parimate/Railway-signalling-system/Arduino MEGA 2560/วงจร/Relay to mega.png

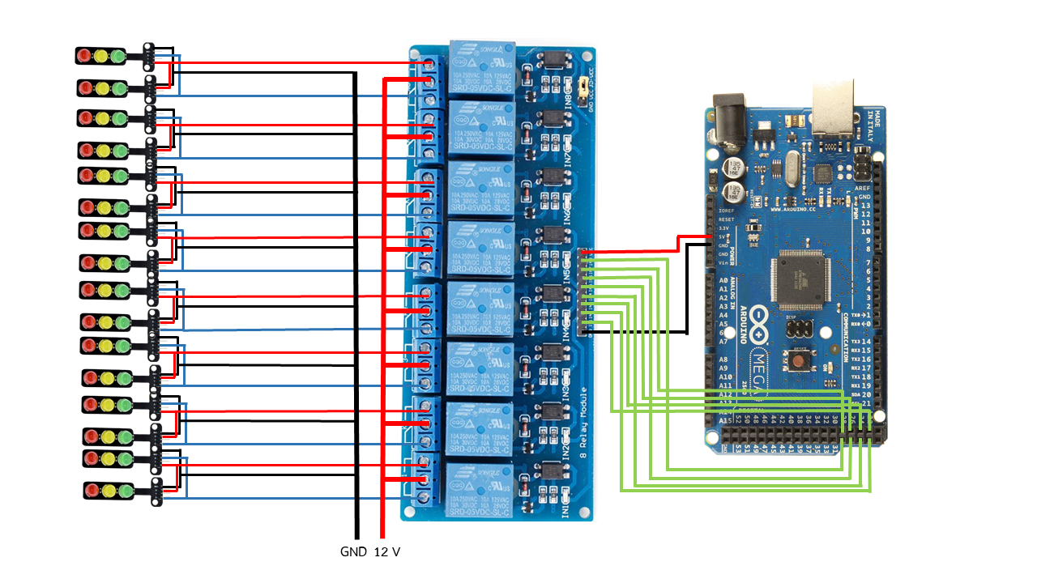
Arduino MEGA 2560/วงจร/Relay to mega.png
