parimate/Railway-signalling-system/NodeMCU ESP8266/RFID to esp8266.jpg

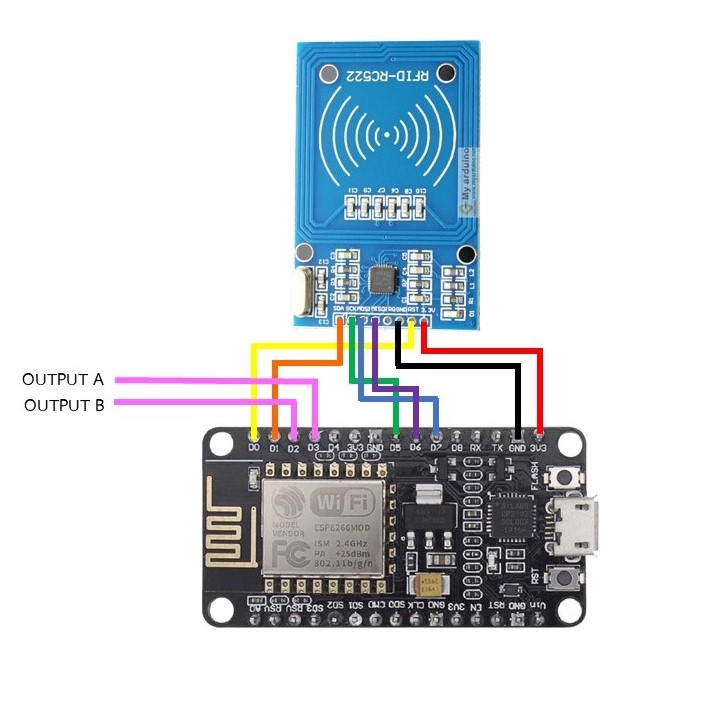
NodeMCU ESP8266/RFID to esp8266.jpg
