parimate/Railway-signalling-system/คู่มือการใช้งาน.pdf

คู่มือการใช้งาน
เมื่อเริ่มระบบการทำงานตัวจอจะแสดงหน้าเมนูหลักขึ้นมา โดยจะแบ่งการใช้งานอยู่ 2 รูปแบบ คือ แบบควบคุมด้วยมือ (Manual) และแบบควบคุมอัตโนมัติ (Auto) หากยังไม่กดปุ่มเลือก รูปแบบการใช้งาน จะไม่สามารถควบคุมการใช้งานของเมนูอื่น ๆ ได้

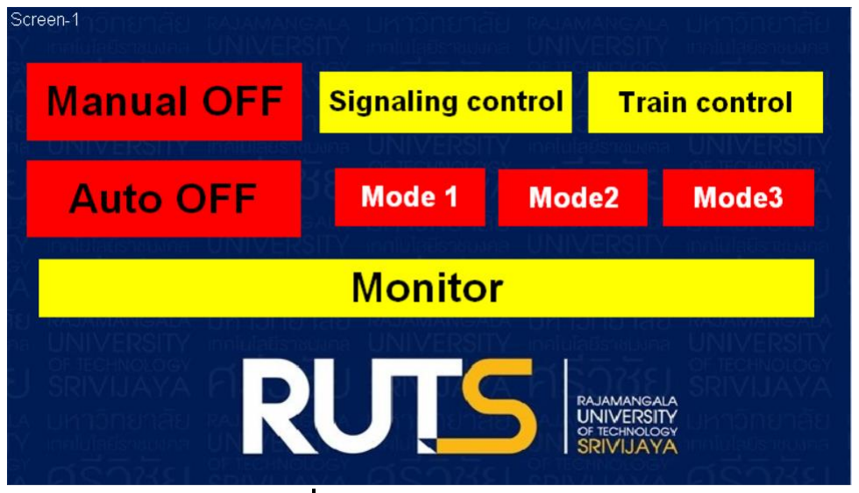
[picture p3: figure]

รูปที่ 1 หน้าเมนูการควบคุม

1. การควบคุมด้วยมือ (Manual)

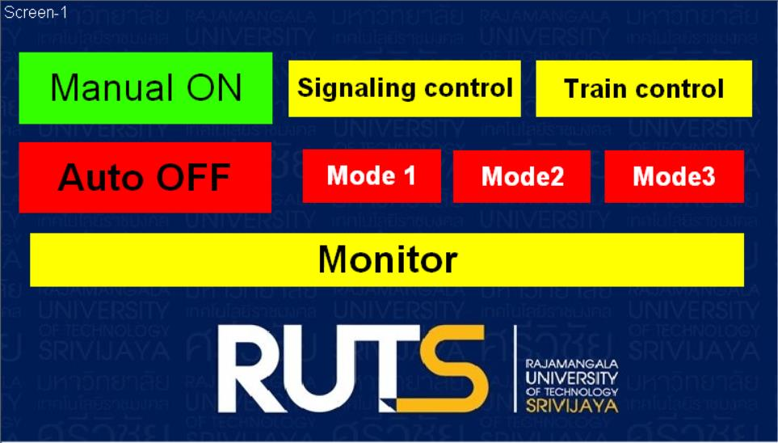
[picture p4: figure]

รูปที่ 2 การควบคุมด้วยมือ

เมื่อกดปุ่ม Manual แล้ว สามารถเลือกเมนูการใช้งานได้ 3 เมนู
- เมนู Signaling control
- เมนู Train control
- เมนู Monitor

1.1 เมนู Signaling control ใช้สำหรับควบคุมไฟบอกสัญญาณและควบคุมประแจสลับรางรถไฟ

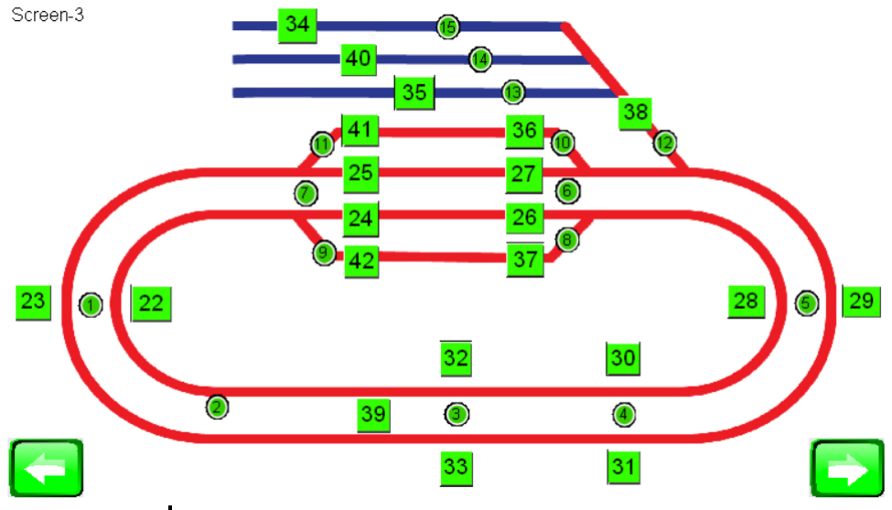
[picture p5: figure]

รูปที่ 3 การควบคุมไฟบอกสัญญาณและประแจสับราง

1.2 เมนู Train control
หน้าจอเมนูนี้จะสามารถแสดงความเร็วของรถไฟ และสามารถควบคุมรถไฟให้เดินหน้า หรือถอยหลังได้

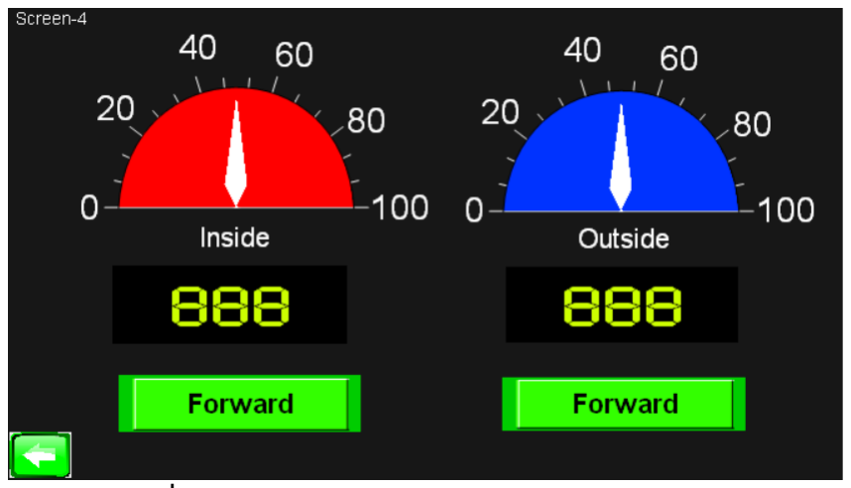
[picture p6: figure]

รูปที่ 4 แสดงความเร็วและควบคุมทิศทางการเดินรถ

ส่วนอุปกรณ์ที่ใช้ในการควบคุบความเร็วรถของรถไฟ หากต้องการให้รถไฟหยุดให้ปรับ ที่ตัวต้านทานปรับค่าได้หมุนไปทางซ้ายสุด และถ้าต้องการเพิ่มความเร็วของรถไฟให้หมุนไปทางขวา ตามความเร็วที่ต้องการ

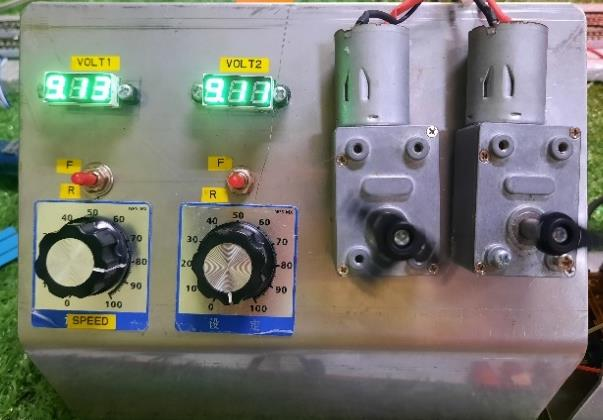
[picture p7: figure]

รูปที่ 5 ตัวควบคุบความเร็วรถรถไฟ

การควบคุมทิศทางให้เดินหน้าหรือถอยหลัง ค่าเดิมของโปรแกรมตั้งค่าให้รถไฟวิ่งไป ด้านหน้า (Forward) ดังรูปที่ 4 หากต้องการให้รถไฟเดินถอยหลัง กดปุ่ม Forward ให้เปลี่ยนเป็น Backward สามารถปรับได้ทั้ง 2 ขบวน ดังรูปที่ 6 และรูปที่ 7

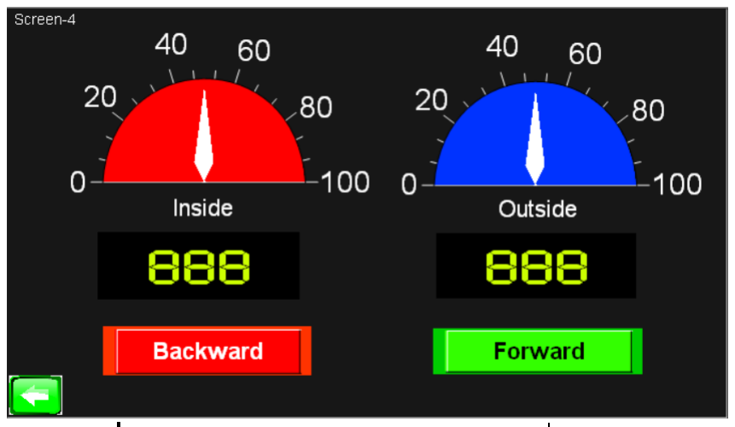
[picture p8: figure]

รูปที่ 6 ควบคุมให้รางด้านใน (Inside) วิ่งถ่อยหลัง

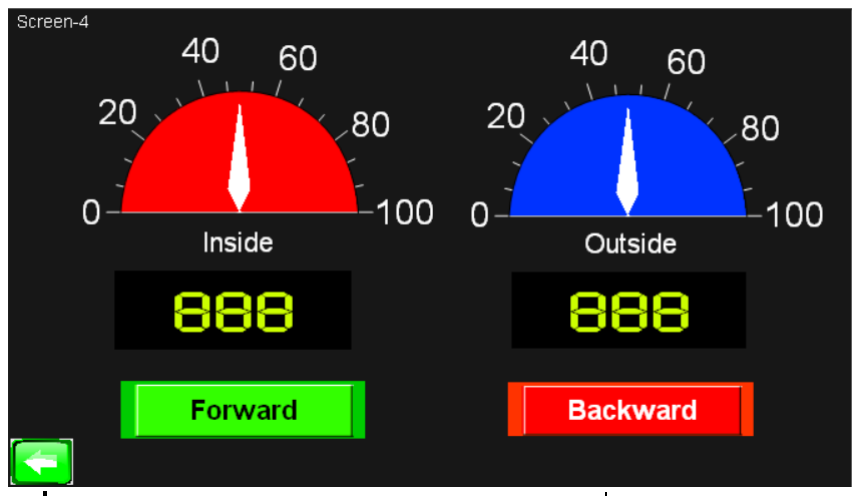
[picture p9: figure]

รูปที่ 7 ควบคุมให้รางด้านนอก (Outside) วิ่งถ่อยหลัง

1.3 เมนู Monitor
ใช้แสดงตำแหน่งของรถไฟทั้งสองขบวน โดยสัญญาณจะส่งมาจากตัวรับสัญญาณ RFID ตามตำแหน่งที่ติดตั้งเสาตัวรับสัญญาณจาก RFID จะแบ่งออกเป็น 3 สถานะ
- สีเขียว คือ ไม่มีรถไฟ
- สีแดง คือ รถไฟขบวน A วิ่งผ่าน
- สีน้ำเงิน คือ รถไฟขบวน B วิ่งผ่าน

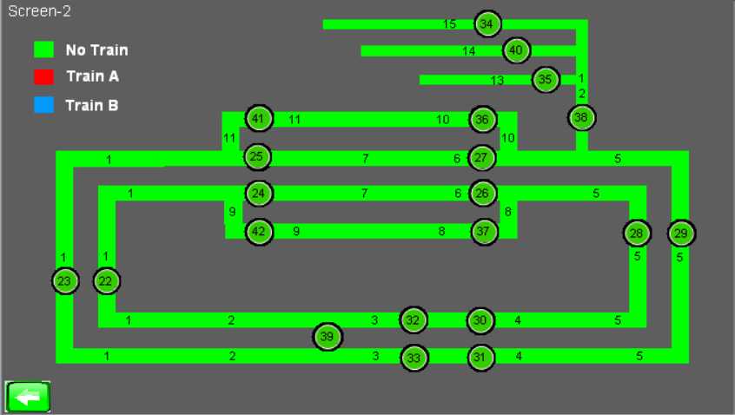
[picture p10: figure]

รูปที่ 8 หน้าระบุตำแหน่งการเดินรถไฟ

2. ควบคุมอัตโนมัติ(Auto)
รูปแบบการควบคุมแบบอัตโนมัติจากมีโหมดให้เลือก3 โหมด โดยแต่ละโหมดใช้แทนการ แบ่งเป็น 3 เส้นทางการเดินรถไฟ ต้องกดปุ่ม Auto ตามด้วยปุ่มโหมดที่ต้องการใช้งาน ระบบจึงจะเริ่ม ทำงาน หากยังไม่กดปุ่มเลือกโหมดการเดินรถและปุ่มโหมดการทำงาน ระบบยังไม่เริ่มการทำงาน

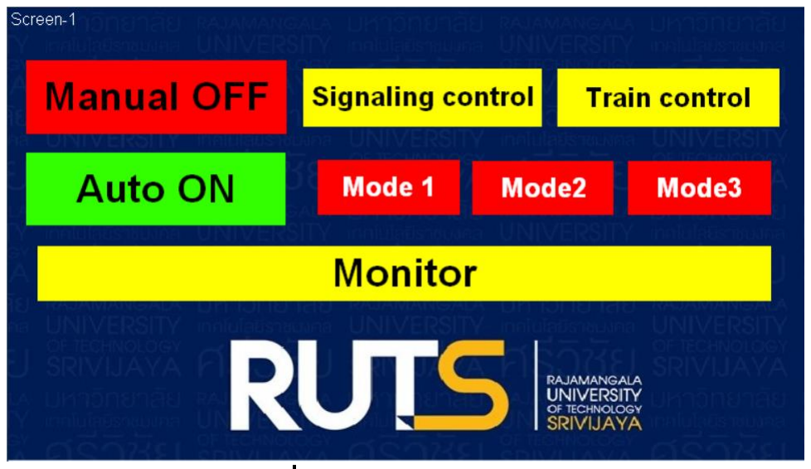
[picture p11: figure]

รูปที่ 9 การควบคุมอัตโนมัติ

2.1 ควบคุมอัตโนมัติ โหมดที่ 1
การเดินรถในโหมดที่ 1 นั้น รถไฟวิ่งตามเส้นทาง ดังรูปที่ 11 โดยรถไฟทั้ง 2 ขบวน วิ่ง ถึงชานชาลา รถไฟจะหยุดวิ่ง 5 วินาที เพื่อจำลองการจอดรับผู้โดยสาร แล้วจึงวิ่งต่อ

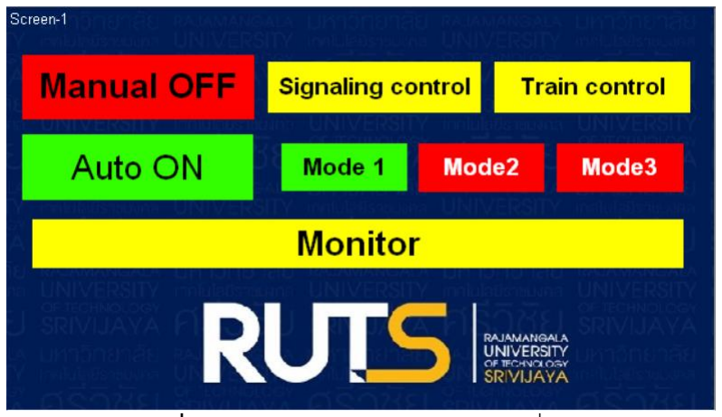
[picture p12: figure]

รูปที่ 10 เลือกเส้นทางการเดินรถโหมดที่ 1

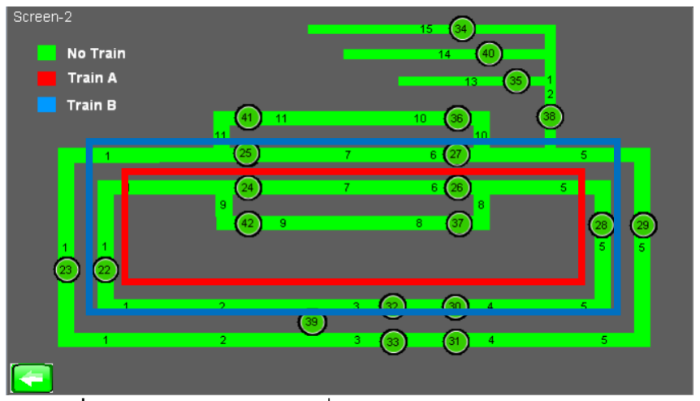
[picture p13: figure]

รูปที่ 11 การเดินรถไฟโหมดที่ 1 ของรถไฟขบวน A และขบวน B

2.2 ควบคุมอัตโนมัติ โหมดที่ 2
การเดินรถในโหมดที่ 2 นั้น เส้นทางการเดินรถไฟ ดังรูปที่ 13 ตัวประแจสลับรางก่อน ถึงชานชาลารถไฟ สลับให้รถไฟวิ่งเข้ามาจอดช่องทางด้านข้างของชานชาลารถไฟ จากนั้นรถไฟหยุดวิ่ง 5 วินาที เพื่อจำลองการจอดรับผู้โดยสาร แล้วจึงวิ่งต่อ

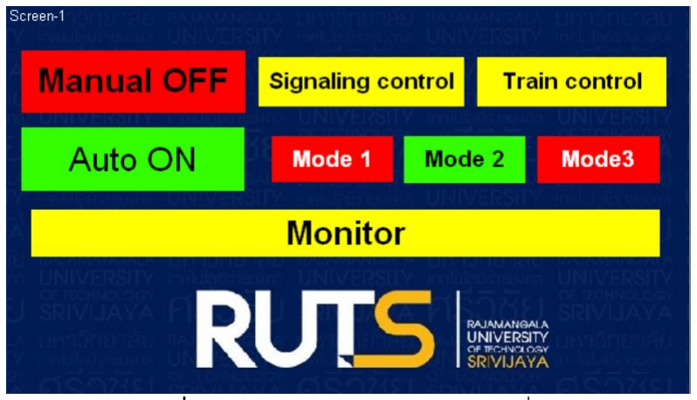
[picture p14: figure]

รูปที่12 เลือกเส้นทางการเดินรถโหมดที่ 2

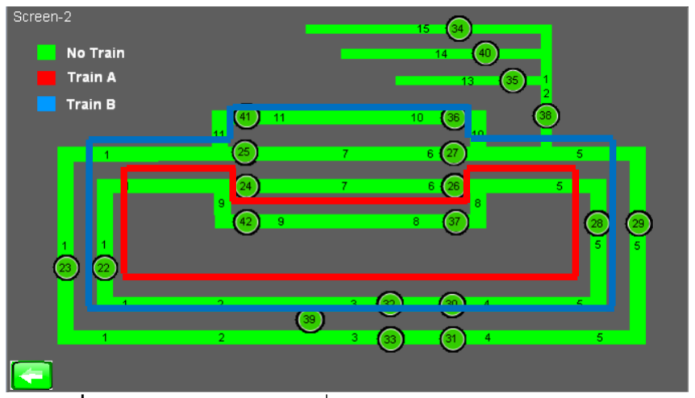
[picture p15: figure]

รูปที่ 13 การเดินรถไฟโหมดที่ 2 ของรถไฟขบวน A และขบวน B

2.3 ควบคุมอัตโนมัติ โหมดที่ 3
การเดินรถในโหมดที่ 3 นั้น เส้นทางการเดินรถไฟ ดังรูปที่ 15 ระบบกำหนดเส้นให้รถไฟ ขบวน A และขบวน B วิ่งไปยังสถานีซ่อมบำรุง

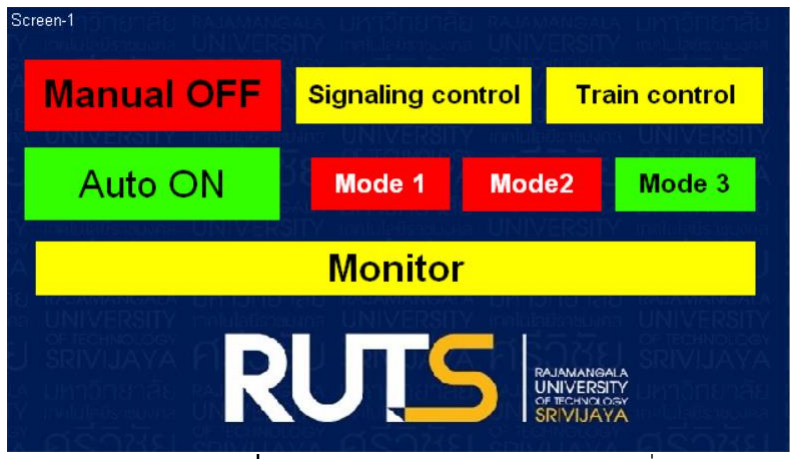
[picture p16: figure]

รูปที่ 14 เลือกเส้นทางการเดินรถโหมดที่ 3

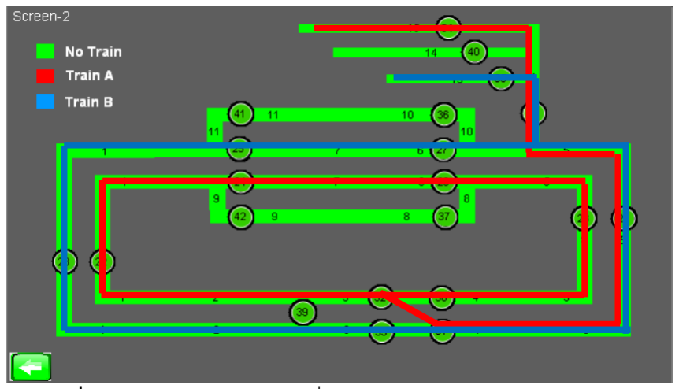
[picture p17: figure]

รูปที่ 15 การเดินรถไฟโหมดที่ 3 ของรถไฟขบวน A และขบวน B
