parimate/Railway-signalling-system/Arduino MEGA 2560/วงจร/วงจรรวม.png

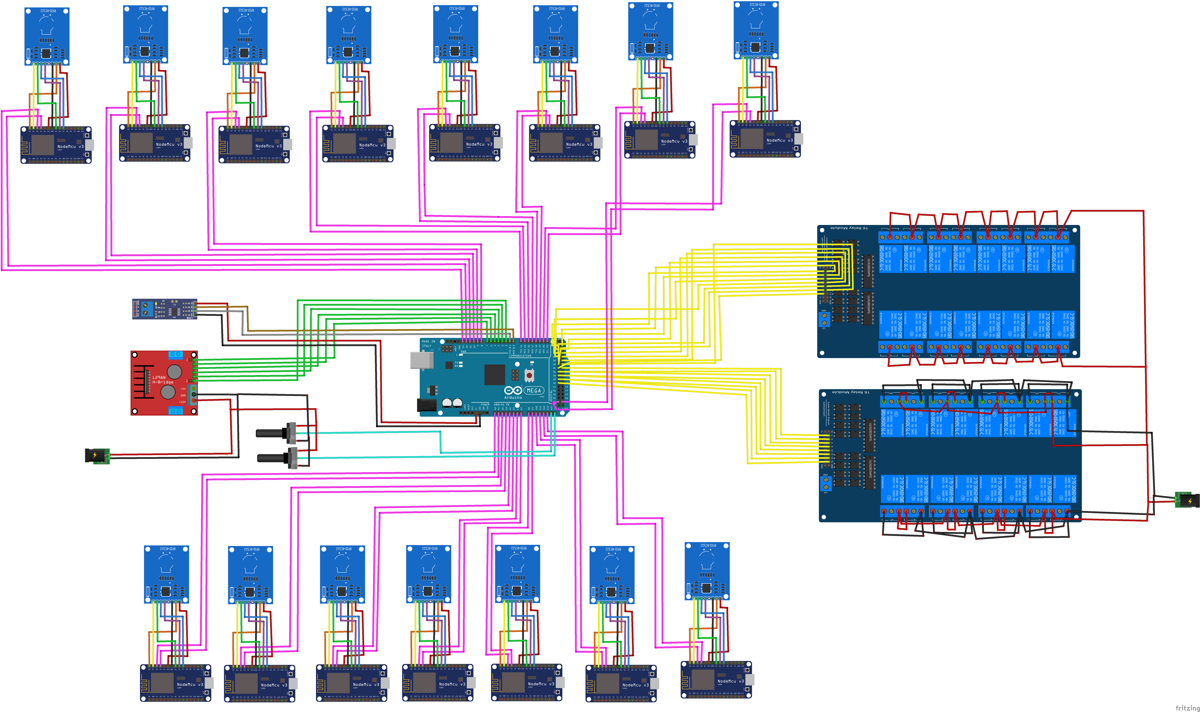
Arduino MEGA 2560/วงจร/วงจรรวม.png
