parimate/Railway-signalling-system/HMI/Background/Monitor.jpg

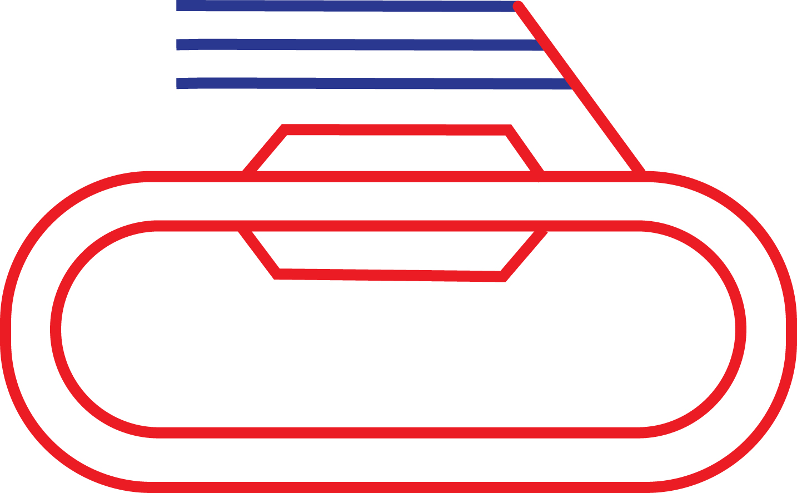
HMI/Background/Monitor.jpg
