parimate/Railway-signalling-system/HMI/Background/wallpaper.jpg

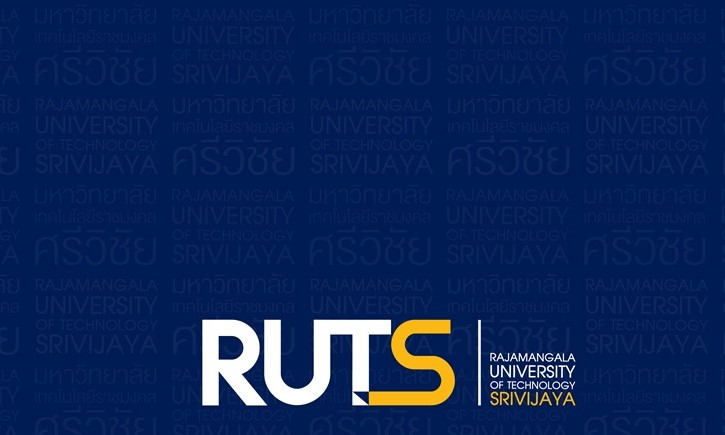
HMI/Background/wallpaper.jpg
